gunicsba/AOG_Amaspray/PCB/BOM_AmatronWithOpto_PCB_AmatronWithOpto_2026-01-19.xlsx

No. | Quantity | Comment | Designator | Footprint | Value | Manufacturer Part | Manufacturer | Supplier Part | Supplier | Device | Name | Description | Resistance - Post Trip (R1) (Max) | Resistance - Initial (Ri) (Min)
1 | 1 | 100nF | C36 | C0402 | 100nF | CL05B104KO5NNNC | SAMSUNG(三星) | C1525 | LCSC | CL05B104KO5NNNC | 100nF | Capacitance: Tolerance:±10% Tolerance:±10% Voltage Rated: Temperature Coefficient:
2 | 2 | 100nF | C55,C58 | C0603 | 100nF | CC0603KRX7R9BB104 | YAGEO(国巨) | C14663 | LCSC | CC0603KRX7R9BB104 | 100nF | Capacitance:100nF Tolerance:±10% Tolerance:±10% Voltage Rating:50V Temperature Coefficient:X7R
3 | 1 | 10uF | C57 | C1206 | 10uF | CL31A106KBHNNNE | SAMSUNG(三星) | C13585 | LCSC | CL31A106KBHNNNE | 10uF | Capacitance:10uF Tolerance:±10% Tolerance:±10% Voltage Rating:50V Temperature Coefficient:X5R
4 | 3 | 100uF | C59,C60,C61 | C1206 | 100uF | CL31A107MQHNNNE | SAMSUNG(三星) | C15008 | LCSC | CL31A107MQHNNNE | 100uF | Capacitance:100uF Tolerance:±20% Tolerance:±20% Voltage Rating:6.3V Temperature Coefficient:X5R
5 | 1 | SS54 | D6 | SMA_L4.4-W2.8-LS5.4-R-RD |  | SS54 | MDD(辰达半导体) | C22452 | LCSC | SS54_C22452 | SS54 | Diode Configuration:Independent Voltage - Forward(Vf@If):550mV@5A Voltage - DC Reverse(Vr):40V Current - Rectified:5A Reverse Leakage Current (Ir):1mA@40V Operating Junction Temperature Range:-55℃~+125℃ Operating Junction Temperature Range:-55℃~+125℃
6 | 1 | 1N5819WS | D7 | SOD-323_L1.8-W1.3-LS2.5-RD |  | 1N5819WS | Hottech(合科泰) | C191023 | LCSC | 1N5819WS_C191023 | 1N5819WS | Voltage - Forward(Vf@If):600mV@1A Voltage - DC Reverse(Vr):40V Current - Rectified:1A Non-Repetitive Peak Forward Surge Current:25A
7 | 1 | 15uH | L9 | IND-SMD_L7.0-W6.6_FXL0630 | 15uH | FXL0630-150-M | cjiang(长江微电) | C177243 | LCSC | FXL0630-150-M | 15uH | Inductance:15uH Tolerance:±20% Tolerance:±20% Current Rating:3A Current - Saturation(Isat):4A DC Resistance(DCR):115mΩ Type:Molded Inductor Ratings:-
8 | 1 | KT-0805G | LED6 | LED0805-R-RD |  | KT-0805G | KENTO | C2297 | LCSC | KT-0805G | KT-0805G | Lamp Holder Type:- Illumination Color:Emerald Green Voltage - Forward(Vf):2.6V~3.1V Voltage - Forward(Vf):2.6V~3.1V Power(Watts):100mW Forward Current:5mA Wavelength - Dominant:513nm~528nm Wavelength - Dominant:513nm~528nm Peak Wavelength:525nm Diode Conf
9 | 18 | Speed Pulse | OPTO_EL37_1A,OPTO_EL37_1B,OPTO_EL37_2A,OPTO_EL37_2B,OPTO_EL37_3A,OPTO_EL37_3B,OPTO_EL37_4A,OPTO_EL37_4B,OPTO_EL37_5A,OPTO_EL37_5B,OPTO_EL37_6A,OPTO_EL37_6B,OPTO_EL37_7A,OPTO_EL37_7B,OPTO_EL37_8A,OPTO_EL37_8B,OPTO_EL37_9A,OPTO_EL37_9B | SOP-4_L4.4-W2.8-P1.27-LS7.0-TL |  | EL3H7(B)(TA)-G | EVERLIGHT(亿光) | C32565 | LCSC | Speed Pulse | Speed Pulse
10 | 1 | AON7544 | Q1 | DFN-8_L3.2-W3.1-P0.65-LS3.4-BL |  | AON7544 | HXY MOSFET(华轩阳电子) | C5261066 | LCSC | AON7544_C5261066 | AON7544 | Number:1 N-Channel Drain to Source Voltage:30V Current - Continuous Drain(Id):100A RDS(on):5.5mΩ@10V,30A Pd - Power Dissipation:62.5W Gate Threshold Voltage (Vgs(th)):2.5V Gate Charge(Qg):31.6nC@4.5V Input Capacitance(Ciss):3.075nF@15V Reverse Transfer Ca
11 | 18 | 200Ω | R1,R2,R3,R4,R5,R6,R7,R8,R9,R10,R11,R12,R13,R14,R15,R16,R17,R48 | R0805 |  | 0805W8F2000T5E | UNI-ROYAL(厚声) | C17540 | LCSC | 200Ω | 200Ω
12 | 1 | 4.7kΩ | R27 | R0402 | 4.7kΩ | 0402WGF4701TCE | UNI-ROYAL(厚声) | C25900 | LCSC | 0402WGF4701TCE | 4.7kΩ | Type:Thick Film Resistor Resistance:4.7kΩ Tolerance:±1% Tolerance:±1% Power(Watts):62.5mW Voltage-Supply(Max):50V Temperature Coefficient:±100ppm/℃ Temperature Coefficient:±100ppm/℃ Operating Temperature:-55℃~+155℃ Operating Temperature:-55℃~+155℃
13 | 1 | 1.5kΩ | R28 | R0402 | 1.5kΩ | 0402WGF1501TCE | UNI-ROYAL(厚声) | C25867 | LCSC | 0402WGF1501TCE | 1.5kΩ | Type:Thick Film Resistors Resistance:1.5kΩ Tolerance:±1% Tolerance:±1% Power(Watts): Overload Voltage (Max): Temperature Coefficient:±100ppm/℃ Temperature Coefficient:±100ppm/℃ Operating Temperature Range:-55℃~+155℃ Operating Temperature Range:-55℃~+155℃
14 | 1 | 15kΩ | R29 | R0402 | 15kΩ | 0402WGF1502TCE | UNI-ROYAL(厚声) | C25756 | LCSC | 0402WGF1502TCE | 15kΩ | 电阻类型:厚膜电阻;阻值:15kΩ;精度:±1%;功率:62.5mW;
15 | 9 | 220Ω | R50,R51,R52,R53,R54,R55,R63,R64,R65 | R0402 | 220Ω | 0402WGF2200TCE | UNI-ROYAL(厚声) | C25091 | LCSC | 0402WGF2200TCE | 220Ω | Resistance: Tolerance:±1% Tolerance:±1% Power(Watts): Overload Voltage (Max): Temperature Coefficient:±100ppm/℃ Temperature Coefficient:±100ppm/℃ Type:Thick Film Resistors Operating Temperature Range:-55℃~+155℃ Operating Temperature Range:-55℃~+155℃
16 | 2 | 4.7kΩ | R92,R93 | R0805 | 4.7kΩ | 0805W8F4701T5E | UNI-ROYAL(厚声) | C17673 | LCSC | 0805W8F4701T5E | 4.7kΩ | Resistance:4700Ω Tolerance:±1% Tolerance:±1% Power(Watts): Overload Voltage (Max): Temperature Coefficient:±100ppm/℃ Temperature Coefficient:±100ppm/℃ Type:Thick Film Resistors Operating Temperature Range:-55℃~+155℃ Operating Temperature Range:-55℃~+155℃
17 | 1 | {ManufacturerPart!} | U19 | TSSOP-28_L9.7-W4.4-P0.65-LS6.4-TL |  | PCA9685PW,118 | NXP(恩智浦) | C2678753 | LCSC | PCA9685PW,118 | {ManufacturerPart!}
18 | 1 | NCV68061SNAIT1G | U26 | TSOP-6_L3.0-W1.5-P0.95-BL |  | NCV68061SNAIT1G | onsemi(安森美) | C5206748 | LCSC | NCV68061SNAIT1G | NCV68061SNAIT1G
19 | 1 | TPS5430DDAR | U27 | ESOP-8_L4.9-W3.9-P1.27-LS6.0-TL-EP |  | TPS5430DDAR | TI(德州仪器) | C9864 | LCSC | TPS5430DDAR | TPS5430DDAR | Function:Buck Voltage - Supply:5.5V~36V Voltage - Supply:5.5V~36V Output Voltage:1.221V~32.04V Output Voltage:1.221V~32.04V Output Current:3A Frequency - Switching:500kHz Frequency - Switching:500kHz Operating Temperature:-40℃~+125℃@(TJ) Operating Tempera
