gunicsba/AOG_Amaspray/(list of files, drawings)

Other design files:
PCB/ProPrj_AmatronWithOpto_Flex_2026-01-19.epro
